ahearn/lian-v3000-gpu-support/renders/view_front.png

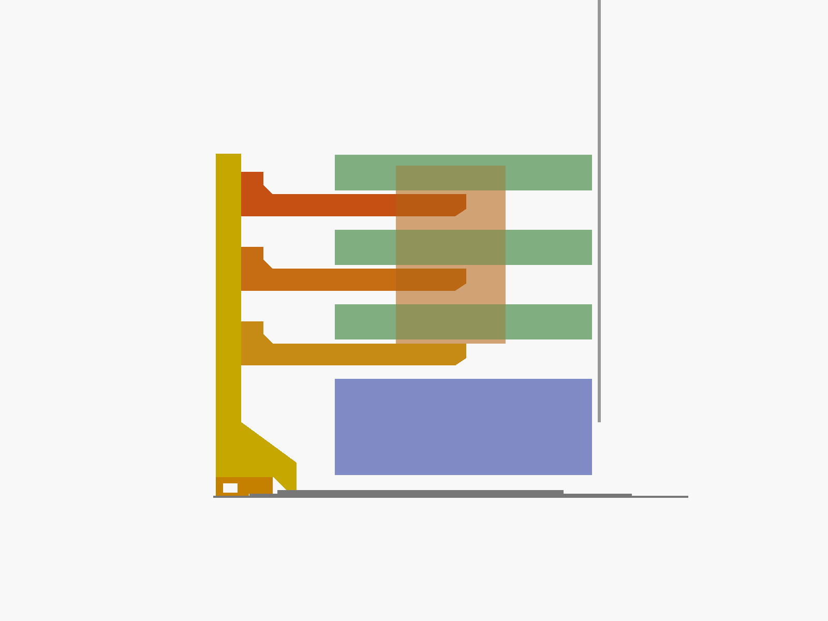
renders/view_front.png
