ahearn/lian-v3000-gpu-support/renders/view_top.png

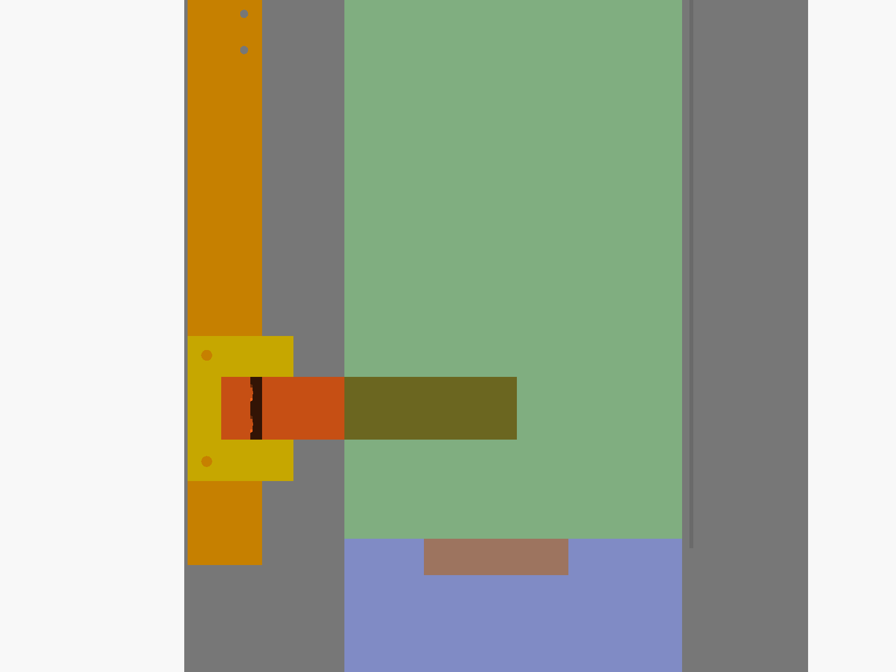
renders/view_top.png
