ahearn/lian-v3000-gpu-support/step/finger1.step

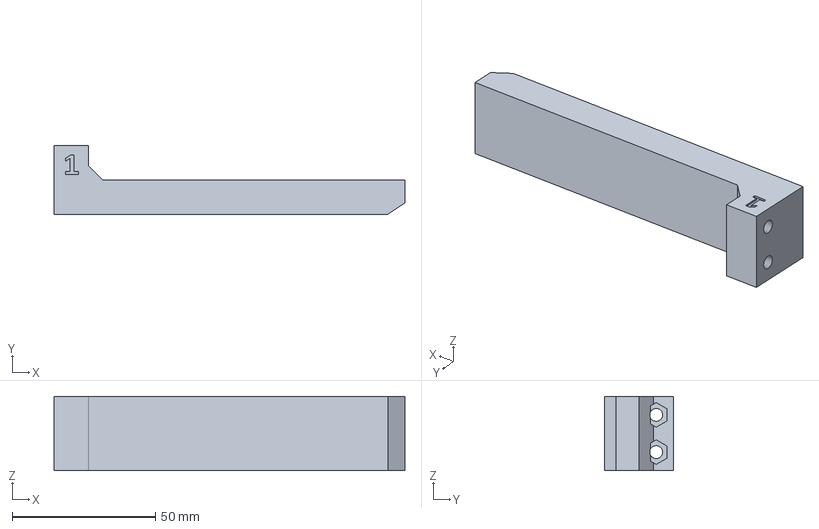
[picture p4: CAD file, 2026-10-18]
step/finger1.step
122.6 x 24.0 x 26.0 mm
