ahearn/lian-v3000-gpu-support/stl/gpus.stl

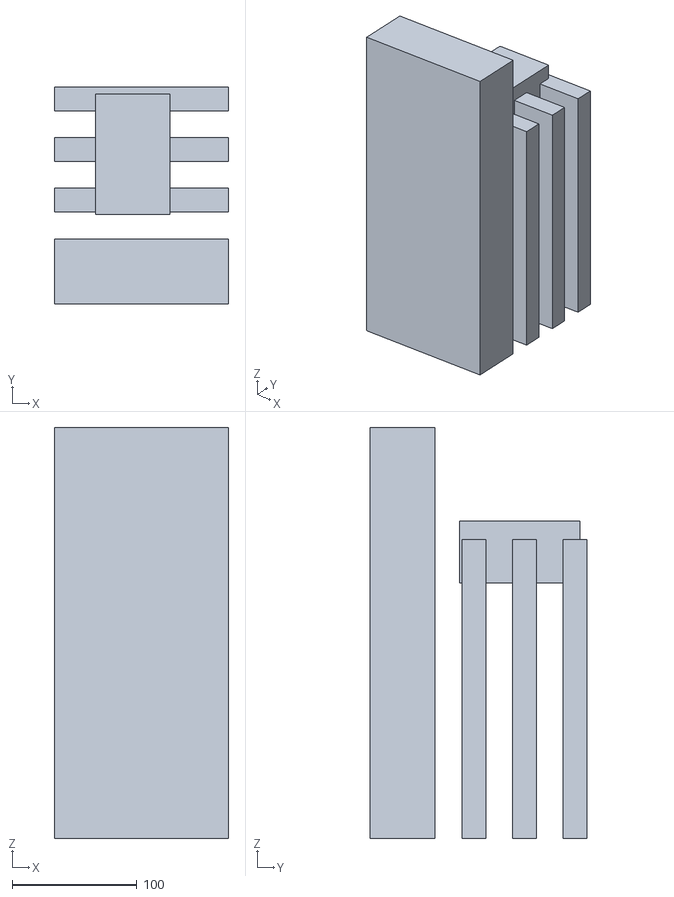
[picture p5: CAD file, 2026-10-18]
stl/gpus.stl
140.0 x 174.3 x 330.0
