ahearn/lian-v3000-gpu-support/stl/parts_in_case.stl

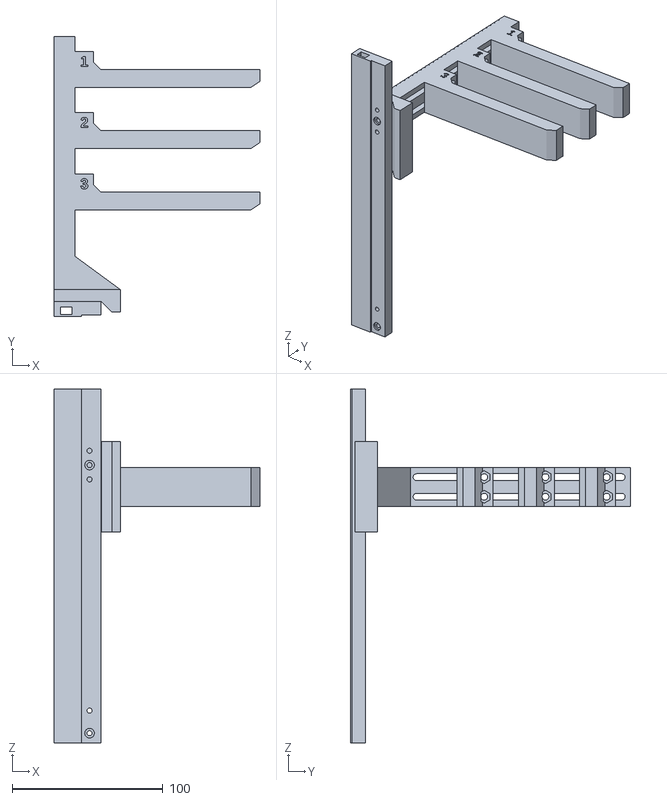
[picture p6: CAD file, 2026-10-18]
stl/parts_in_case.stl
136.5 x 186.2 x 235.0
