ahearn/lian-v3000-gpu-support/step/column.step

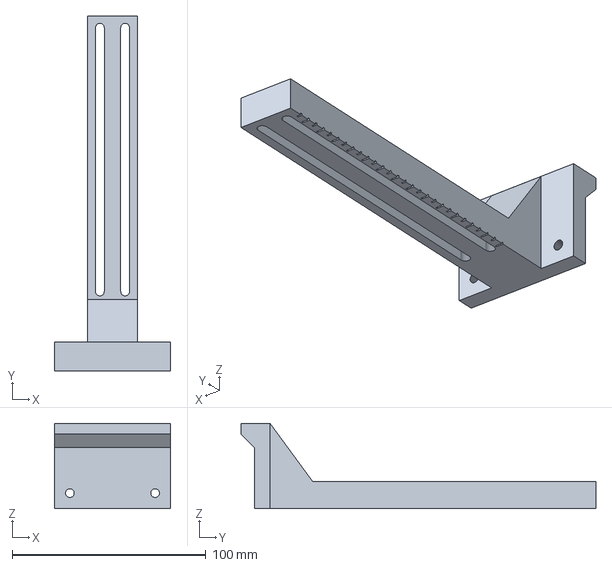
[picture p7: CAD file, 2026-10-18]
step/column.step
60.0 x 183.2 x 44.0 mm
