ahearn/lian-v3000-gpu-support/stl/plate.stl

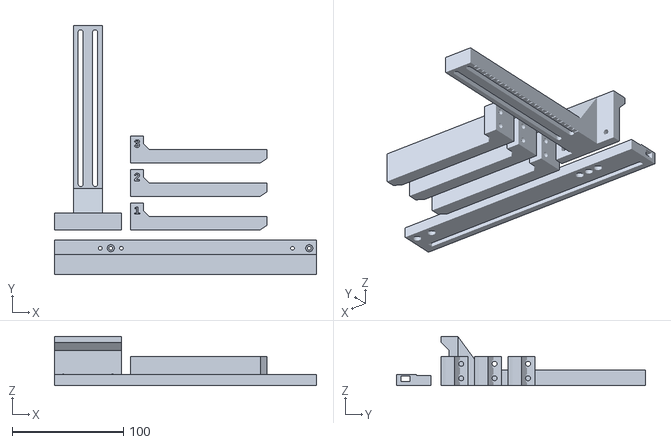
[picture p8: CAD file, 2026-10-18]
stl/plate.stl
235.0 x 223.2 x 44.0
