ahearn/lian-v3000-gpu-support/step/rail.step

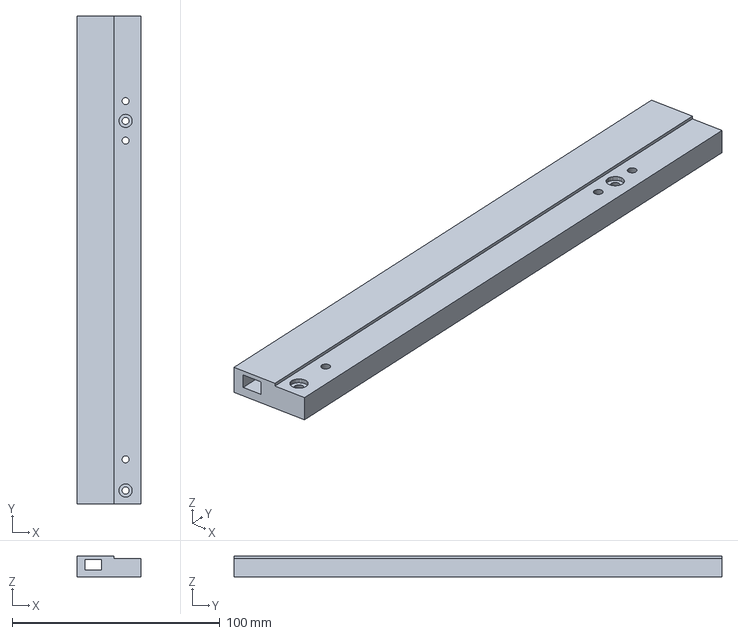
[picture p9: CAD file, 2026-10-18]
step/rail.step
31.0 x 235.0 x 10.00 mm
