ahearn/lian-v3000-gpu-support/(list of files, cad)

Other CAD files:
step/finger3.step
step/finger2.step
stl/column.stl
stl/finger1.stl
stl/finger2.stl
stl/finger3.stl
stl/rail.stl
