ahearn/lian-v3000-gpu-support/renders/print_plate.png

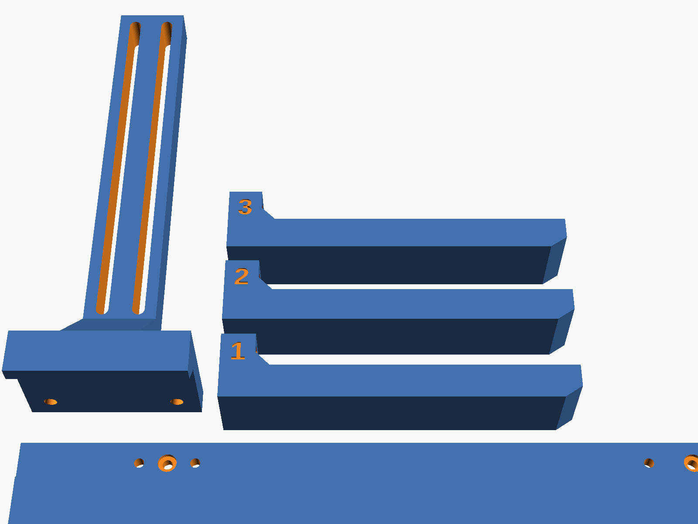
renders/print_plate.png
